Loredati-svg/BLDC-FOC-Motor-Driver/Hardware/FOC_Driver/FOC_Driver.kicad_pcb

## KiCad design Hardware/FOC_Driver/FOC_Driver.kicad_pcb (2026-10-24)

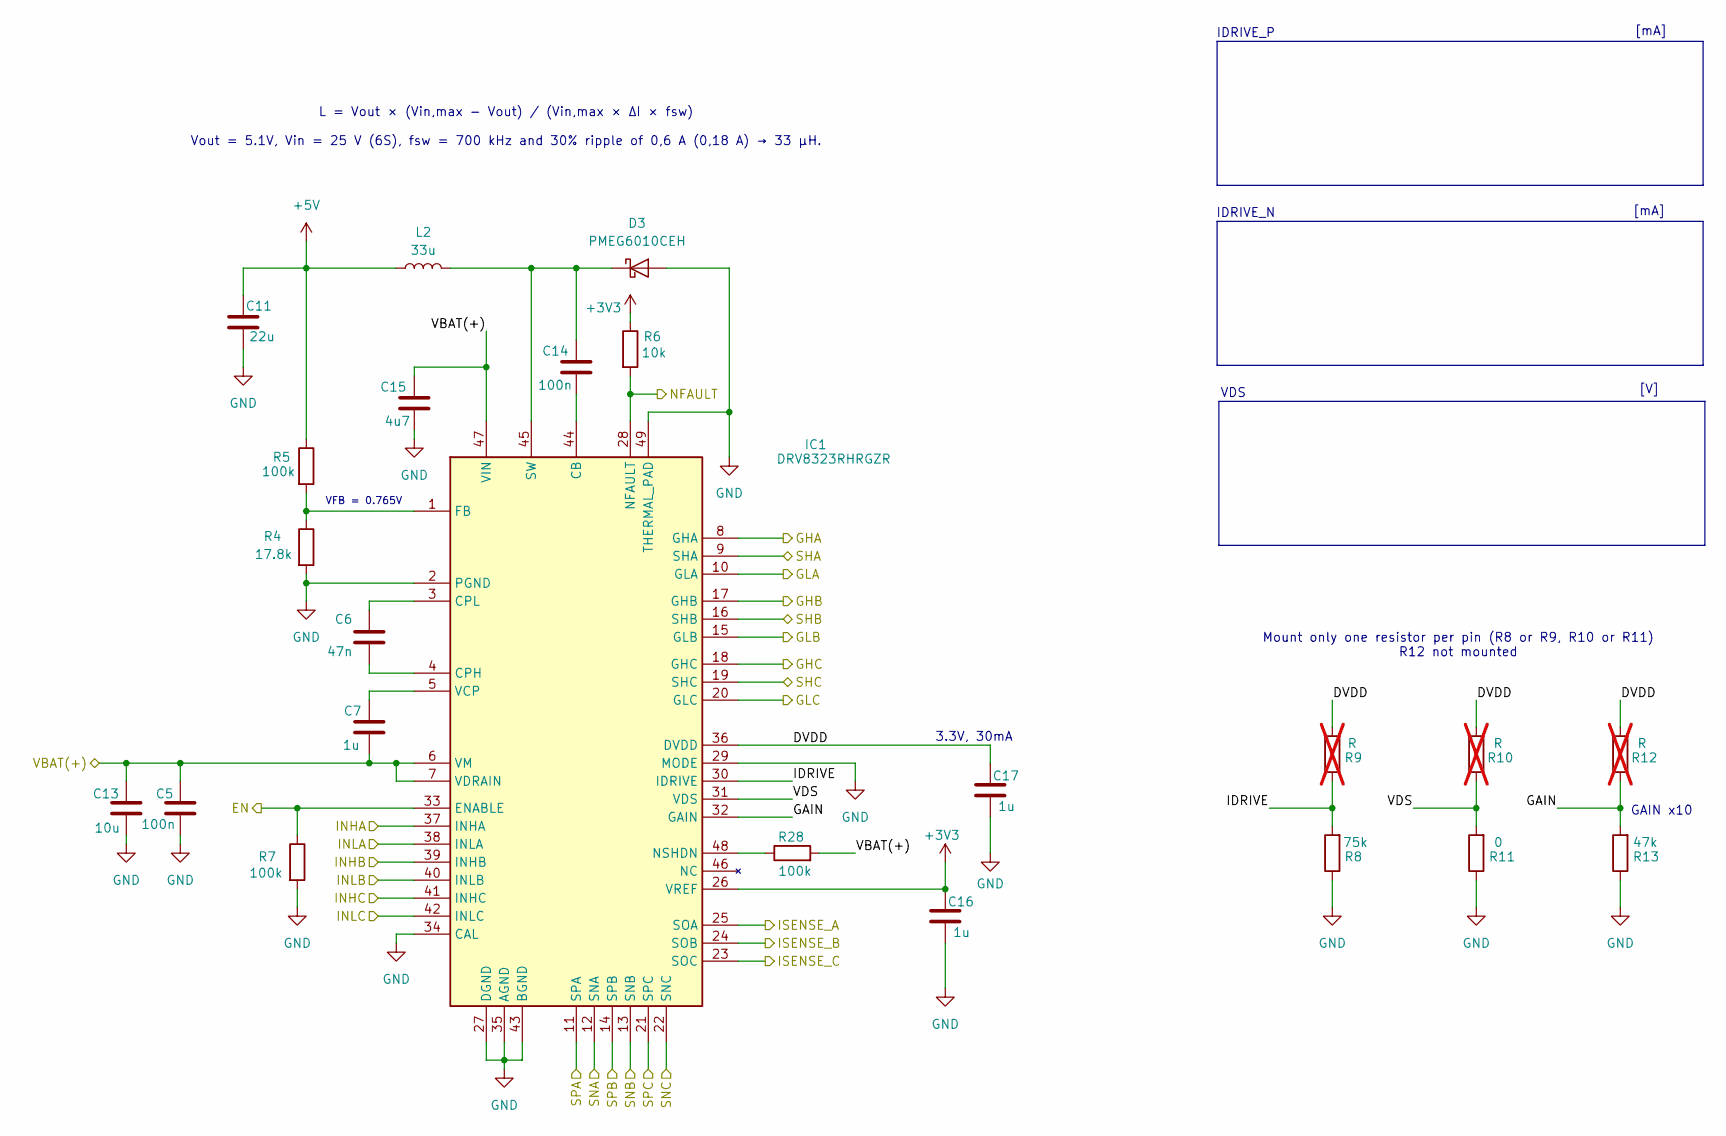
[picture p3: schematic Gate_Driver_sch.kicad_sch]

Parts:
C5: 100n; 0603
C6: 47n; 0603
C7: 1u; 0603
C11: 22u; 1206
C13: 10u; 1210
C14: 100n; 0402
C15: 4u7; 0805
C16, C17: 1u; 0402
D3: PMEG6010CEH; D_SOD-123F
IC1: DRV8323RHRGZR; QFN50P700X700X100-49N-D; Mouser Part Number 595-DRV8323RHRGZR
L2: 33u; L_Bourns_SRN6045TA
R4: 17.8k; 0402
R5, R7, R28: 100k; 0402
R6: 10k; 0402
R8: 75k; 0402
R9, R10, R12: R; 0402; not fitted
R11: 0; 0402
R13: 47k; 0402

Connections:
+3V3: C16.1, IC1.26 (VREF), R6.1; also elsewhere on the board
+5V: C11.1, L2.1, R5.1; also elsewhere on the board
/Gate_Driver/DVDD: C17.1, IC1.36 (DVDD), R9.2, R10.2, R12.2
/Gate_Driver/EN: IC1.33 (ENABLE), R7.1; also elsewhere on the board
/Gate_Driver/GAIN: IC1.32 (GAIN), R12.1, R13.2
/Gate_Driver/GHA: IC1.8 (GHA); also elsewhere on the board
/Gate_Driver/GHB: IC1.17 (GHB); also elsewhere on the board
/Gate_Driver/GHC: IC1.18 (GHC); also elsewhere on the board
/Gate_Driver/GLA: IC1.10 (GLA); also elsewhere on the board
/Gate_Driver/GLB: IC1.15 (GLB); also elsewhere on the board
/Gate_Driver/GLC: IC1.20 (GLC); also elsewhere on the board
/Gate_Driver/IDRIVE: IC1.30 (IDRIVE), R8.2, R9.1
/Gate_Driver/INHA: IC1.37 (INHA); also elsewhere on the board
/Gate_Driver/INHB: IC1.39 (INHB); also elsewhere on the board
/Gate_Driver/INHC: IC1.41 (INHC); also elsewhere on the board
/Gate_Driver/INLA: IC1.38 (INLA); also elsewhere on the board
/Gate_Driver/INLB: IC1.40 (INLB); also elsewhere on the board
/Gate_Driver/INLC: IC1.42 (INLC); also elsewhere on the board
/Gate_Driver/ISENSE_A: IC1.25 (SOA); also elsewhere on the board
/Gate_Driver/ISENSE_B: IC1.24 (SOB); also elsewhere on the board
/Gate_Driver/ISENSE_C: IC1.23 (SOC); also elsewhere on the board
/Gate_Driver/NFAULT: IC1.28 (NFAULT), R6.2; also elsewhere on the board
/Gate_Driver/SNA: IC1.12 (SNA); also elsewhere on the board
/Gate_Driver/SNB: IC1.13 (SNB); also elsewhere on the board
/Gate_Driver/SNC: IC1.22 (SNC); also elsewhere on the board
/Gate_Driver/SPA: IC1.11 (SPA); also elsewhere on the board
/Gate_Driver/SPB: IC1.14 (SPB); also elsewhere on the board
/Gate_Driver/SPC: IC1.21 (SPC); also elsewhere on the board
/Gate_Driver/VBAT(+): C5.1, C7.1, C13.1, C15.2, IC1.6 (VM), IC1.7 (VDRAIN), IC1.47 (VIN), R28.2; also elsewhere on the board
/Gate_Driver/VDS: IC1.31 (VDS), R10.1, R11.2
/SHA: IC1.9 (SHA); also elsewhere on the board
/SHB: IC1.16 (SHB); also elsewhere on the board
/SHC: IC1.19 (SHC); also elsewhere on the board
GND: C5.2, C11.2, C13.2, C15.1, C16.2, C17.2, D3.2 (A), IC1.2 (PGND), IC1.27 (DGND), IC1.29 (MODE), IC1.34 (CAL), IC1.35 (AGND), IC1.43 (BGND), IC1.49 (THERMAL_PAD), R4.2, R7.2, R8.1, R11.1, R13.1; also elsewhere on the board
unnamed: C14.2, D3.1 (K), IC1.45 (SW), L2.2
unnamed: C14.1, IC1.44 (CB)
unnamed: C6.1, IC1.4 (CPH)
unnamed: C6.2, IC1.3 (CPL)
unnamed: IC1.1 (FB), R4.1, R5.2
unnamed: IC1.48 (NSHDN), R28.1
unnamed: C7.2, IC1.5 (VCP)

Notes on the sheet:
[V]
3.3V, 30mA
VDS
[mA]
VFB = 0.765V
GAIN x10
IDRIVE_P
Mount only one resistor per pin (R8 or R9, R10 or R11) R12 not mounted
IDRIVE_N
L = Vout × (Vin,max − Vout) / (Vin,max × ΔI × fsw) Vout = 5.1V, Vin = 25 V (6S), fsw = 700 kHz and 30% ripple of 0,6 A (0,18 A) → 33 µH.

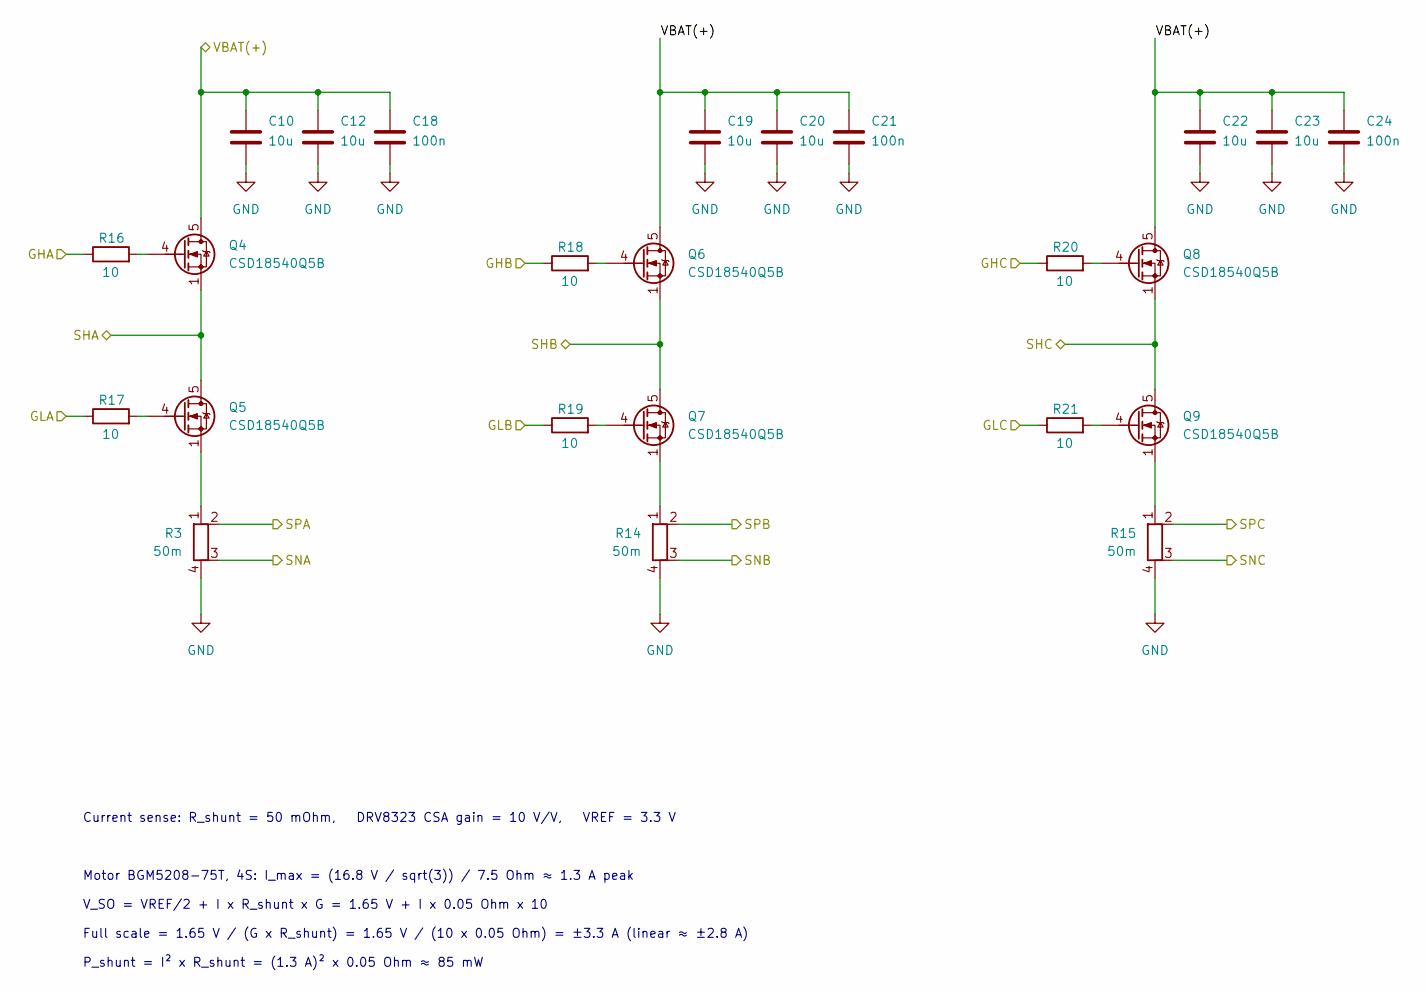
[picture p4: schematic Inverters_sch.kicad_sch]

Parts:
C10, C12, C19, C20, C22, C23: 10u; C_1206_3216Metric
C18, C21, C24: 100n; C_0603_1608Metric
Q4, Q5, Q6, Q7, Q8, Q9: CSD18540Q5B; TDSON-8-1
R3, R14, R15: 50m; R_Shunt_Vishay_WSK2512_6332Metric_T1.19mm
R16, R17, R18, R19, R20, R21: 10; R_0603_1608Metric

Connections:
/Gate_Driver/GHA: R16.1; also elsewhere on the board
/Gate_Driver/GHB: R18.1; also elsewhere on the board
/Gate_Driver/GHC: R20.1; also elsewhere on the board
/Gate_Driver/GLA: R17.1; also elsewhere on the board
/Gate_Driver/GLB: R19.1; also elsewhere on the board
/Gate_Driver/GLC: R21.1; also elsewhere on the board
/Gate_Driver/SNA: R3.3; also elsewhere on the board
/Gate_Driver/SNB: R14.3; also elsewhere on the board
/Gate_Driver/SNC: R15.3; also elsewhere on the board
/Gate_Driver/SPA: R3.2; also elsewhere on the board
/Gate_Driver/SPB: R14.2; also elsewhere on the board
/Gate_Driver/SPC: R15.2; also elsewhere on the board
/Gate_Driver/VBAT(+): C10.1, C12.1, C18.1, C19.1, C20.1, C21.1, C22.1, C23.1, C24.1, Q4.5 (D), Q6.5 (D), Q8.5 (D); also elsewhere on the board
/SHA: Q4.1 (S), Q4.2 (S), Q4.3 (S), Q5.5 (D); also elsewhere on the board
/SHB: Q6.1 (S), Q6.2 (S), Q6.3 (S), Q7.5 (D); also elsewhere on the board
/SHC: Q8.1 (S), Q8.2 (S), Q8.3 (S), Q9.5 (D); also elsewhere on the board
GND: C10.2, C12.2, C18.2, C19.2, C20.2, C21.2, C22.2, C23.2, C24.2, R3.4, R14.4, R15.4; also elsewhere on the board
unnamed: Q4.4 (G), R16.2
unnamed: Q5.4 (G), R17.2
unnamed: Q5.1 (S), Q5.2 (S), Q5.3 (S), R3.1
unnamed: Q6.4 (G), R18.2
unnamed: Q7.4 (G), R19.2
unnamed: Q7.1 (S), Q7.2 (S), Q7.3 (S), R14.1
unnamed: Q8.4 (G), R20.2
unnamed: Q9.4 (G), R21.2
unnamed: Q9.1 (S), Q9.2 (S), Q9.3 (S), R15.1

Notes on the sheet:
Current sense: R_shunt = 50 mOhm, DRV8323 CSA gain = 10 V/V, VREF = 3.3 V Motor BGM5208-75T, 4S: I_max = (16.8 V / sqrt(3)) / 7.5 Ohm ≈ 1.3 A peak V_SO = VREF/2 + I x R_shunt x G = 1.65 V + I x 0.05 Ohm x 10 Full scale = 1.65 V / (G x R_shunt) = 1.65 V / (10 x 0.05 Ohm) = ±3.3 A (linear ≈ ±2.8 A) P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

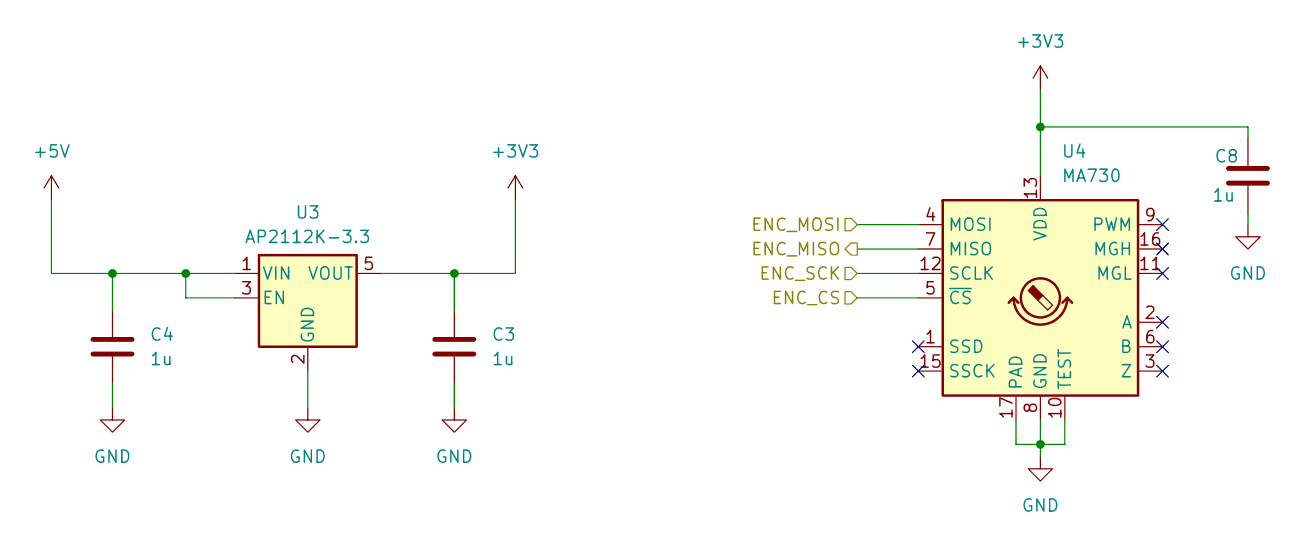
[picture p5: schematic LDO_sch.kicad_sch]

Parts:
C3, C4, C8: 1u; C_0402_1005Metric
U3: AP2112K-3.3; SOT-23-5
U4: MA730; QFN-16-1EP_3x3mm_P0.5mm_EP1.75x1.75mm

Connections:
+3V3: C3.1, C8.1, U3.5 (VOUT), U4.13 (VDD); also elsewhere on the board
+5V: C4.1, U3.1 (VIN), U3.3 (EN); also elsewhere on the board
/LDO + Encoder/ENC_CS: U4.5 (~CS); also elsewhere on the board
/LDO + Encoder/ENC_MISO: U4.7 (MISO); also elsewhere on the board
/LDO + Encoder/ENC_MOSI: U4.4 (MOSI); also elsewhere on the board
/LDO + Encoder/ENC_SCK: U4.12 (SCLK); also elsewhere on the board
GND: C3.2, C4.2, C8.2, U3.2 (GND), U4.8 (GND), U4.10 (TEST), U4.17 (PAD); also elsewhere on the board

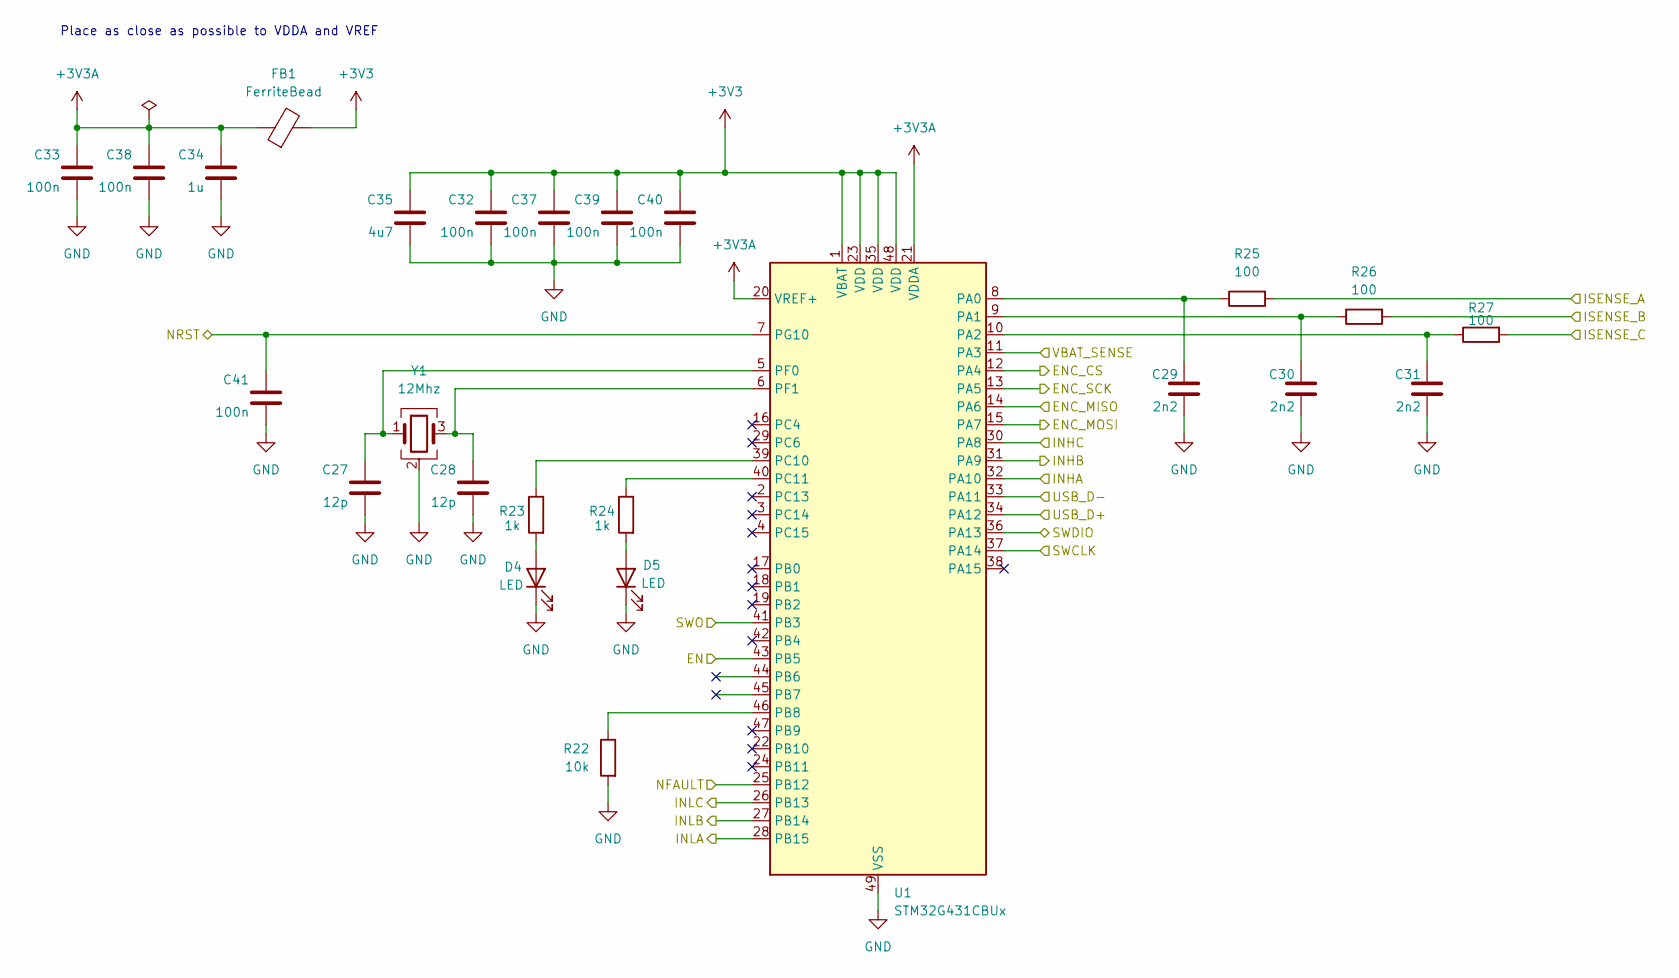
[picture p6: schematic MCU_sch.kicad_sch]

Parts:
C27, C28: 12p; 0402
C29, C30, C31: 2n2; 0402
C32, C33, C37, C38, C39, C40, C41: 100n; 0402
C34: 1u; 0603
C35: 4u7; 0805
D4, D5: LED; 0603_pol
FB1: FerriteBead; 0603
R22: 10k; 0402
R23, R24: 1k; 0402
R25, R26, R27: 100; 0402
U1: STM32G431CBUx; QFN-48-1EP_7x7mm_P0.5mm_EP5.6x5.6mm
Y1: 12Mhz; Crystal_SMD_ECX-32_Series_4Pin_3.2x2.5mm

Connections:
+3V3: C32.2, C35.2, C37.2, C39.2, C40.2, FB1.2, U1.1 (VBAT), U1.23 (VDD), U1.35 (VDD), U1.48 (VDD); also elsewhere on the board
+3V3A: C33.2, C34.2, C38.2, FB1.1, U1.20 (VREF+), U1.21 (VDDA)
/Connectors/NRST: C41.2, U1.7 (PG10); also elsewhere on the board
/Connectors/SWCLK: U1.37 (PA14); also elsewhere on the board
/Connectors/SWDIO: U1.36 (PA13); also elsewhere on the board
/Connectors/SWO: U1.41 (PB3); also elsewhere on the board
/Connectors/USB_D+: U1.34 (PA12); also elsewhere on the board
/Connectors/USB_D-: U1.33 (PA11); also elsewhere on the board
/Connectors/VBAT_SENSE: U1.11 (PA3); also elsewhere on the board
/Gate_Driver/EN: U1.43 (PB5); also elsewhere on the board
/Gate_Driver/INHA: U1.32 (PA10); also elsewhere on the board
/Gate_Driver/INHB: U1.31 (PA9); also elsewhere on the board
/Gate_Driver/INHC: U1.30 (PA8); also elsewhere on the board
/Gate_Driver/INLA: U1.28 (PB15); also elsewhere on the board
/Gate_Driver/INLB: U1.27 (PB14); also elsewhere on the board
/Gate_Driver/INLC: U1.26 (PB13); also elsewhere on the board
/Gate_Driver/ISENSE_A: R25.2; also elsewhere on the board
/Gate_Driver/ISENSE_B: R26.2; also elsewhere on the board
/Gate_Driver/ISENSE_C: R27.2; also elsewhere on the board
/Gate_Driver/NFAULT: U1.25 (PB12); also elsewhere on the board
/LDO + Encoder/ENC_CS: U1.12 (PA4); also elsewhere on the board
/LDO + Encoder/ENC_MISO: U1.14 (PA6); also elsewhere on the board
/LDO + Encoder/ENC_MOSI: U1.15 (PA7); also elsewhere on the board
/LDO + Encoder/ENC_SCK: U1.13 (PA5); also elsewhere on the board
GND: C27.1, C28.1, C29.1, C30.1, C31.1, C32.1, C33.1, C34.1, C35.1, C37.1, C38.1, C39.1, C40.1, C41.1, D4.1 (K), D5.1 (K), R22.2, U1.49 (VSS), Y1.2 (G), Y1.4 (G); also elsewhere on the board
unnamed: D4.2 (A), R23.2
unnamed: D5.2 (A), R24.2
unnamed: C29.2, R25.1, U1.8 (PA0)
unnamed: C30.2, R26.1, U1.9 (PA1)
unnamed: C31.2, R27.1, U1.10 (PA2)
unnamed: R22.1, U1.46 (PB8)
unnamed: R23.1, U1.39 (PC10)
unnamed: R24.1, U1.40 (PC11)
unnamed: C27.2, U1.5 (PF0), Y1.1
unnamed: C28.2, U1.6 (PF1), Y1.3

Notes on the sheet:
Place as close as possible to VDDA and VREF

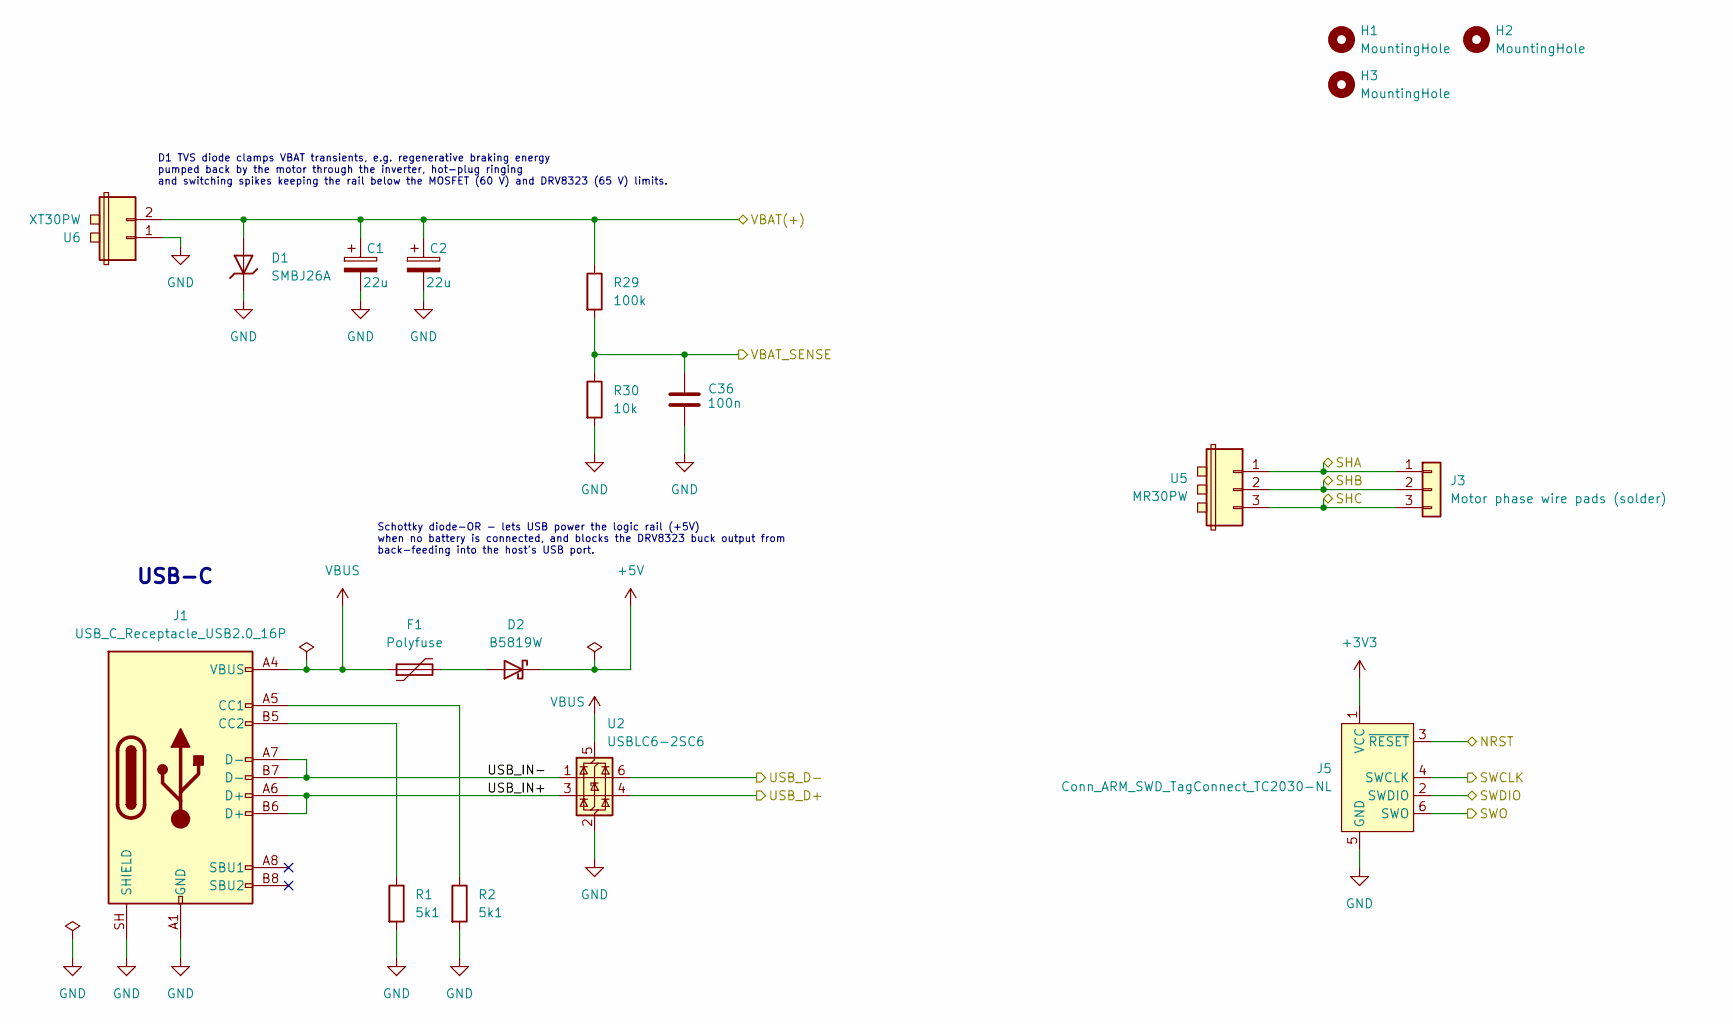
[picture p7: schematic Connectors_sch.kicad_sch]

Parts:
C1, C2: 22u; CP_Elec_6.3x5.4
C36: 100n; 0402
D1: SMBJ26A; D_SMB; Part SMBJ26A; LCSC C19077580
D2: B5819W; D_SOD-123; Forward Voltage (Vf@If) 900mV@3A; Reverse Voltage (Vr) 40V; Part B5819W; LCSC C64885
F1: Polyfuse; Fuse_1206_3216Metric
H1, H2, H3: MountingHole; MountingHole_2.7mm_M2.5_DIN965_Pad_TopOnly
J1: USB_C_Receptacle_USB2.0_16P; USB_C_Receptacle_GCT_USB4105-xx-A_16P_TopMnt_Horizontal
J3: Motor phase wire pads (solder); SolderWire-0.5sqmm_1x03_P4.6mm_D0.9mm_OD2.1mm
J5: Conn_ARM_SWD_TagConnect_TC2030-NL; Tag-Connect_TC2030-IDC-NL_2x03_P1.27mm_Vertical
R1, R2: 5k1; R_0402_1005Metric
R29: 100k; 0603
R30: 10k; 0603
U2: USBLC6-2SC6; SOT-23-6
U5: MR30PW; AMASS_MR30PW-M_1x03_P3.50mm_Horizontal
U6: XT30PW; AMASS_XT30PW-M_1x02_P2.50mm_Horizontal

Connections:
+3V3: J5.1 (VCC); also elsewhere on the board
+5V: D2.1; also elsewhere on the board
/Connectors/NRST: J5.3 (~RESET); also elsewhere on the board
/Connectors/SWCLK: J5.4 (SWCLK); also elsewhere on the board
/Connectors/SWDIO: J5.2 (SWDIO); also elsewhere on the board
/Connectors/SWO: J5.6 (SWO); also elsewhere on the board
/Connectors/USB_D+: U2.4 (I/O2); also elsewhere on the board
/Connectors/USB_D-: U2.6 (I/O1); also elsewhere on the board
/Connectors/USB_IN+: J1.A6 (D+), J1.B6 (D+), U2.3 (I/O2)
/Connectors/USB_IN-: J1.A7 (D-), J1.B7 (D-), U2.1 (I/O1)
/Connectors/VBAT_SENSE: C36.2, R29.2, R30.1; also elsewhere on the board
/Gate_Driver/VBAT(+): C1.1, C2.1, D1.2, R29.1, U6.2; also elsewhere on the board
/SHA: J3.1, U5.1; also elsewhere on the board
/SHB: J3.2, U5.2; also elsewhere on the board
/SHC: J3.3, U5.3; also elsewhere on the board
GND: C1.2, C2.2, C36.1, D1.1, J1.A1 (GND), J1.A12 (GND), J1.B1 (GND), J1.B12 (GND), J1.SH (SHIELD), J5.5 (GND), R1.2, R2.2, R30.2, U2.2 (GND), U6.1; also elsewhere on the board
unnamed: D2.2, F1.2
unnamed: J1.A5 (CC1), R2.1
unnamed: J1.B5 (CC2), R1.1
VBUS: F1.1, J1.A4 (VBUS), J1.A9 (VBUS), J1.B4 (VBUS), J1.B9 (VBUS), U2.5 (VBUS)

Notes on the sheet:
Schottky diode-OR - lets USB power the logic rail (+5V) when no battery is connected, and blocks the DRV8323 buck output from back-feeding into the host's USB port.
D1 TVS diode clamps VBAT transients, e.g. regenerative braking energy pumped back by the motor through the inverter, hot-plug ringing and switching spikes keeping the rail below the MOSFET (60 V) and DRV8323 (65 V) limits.
USB-C

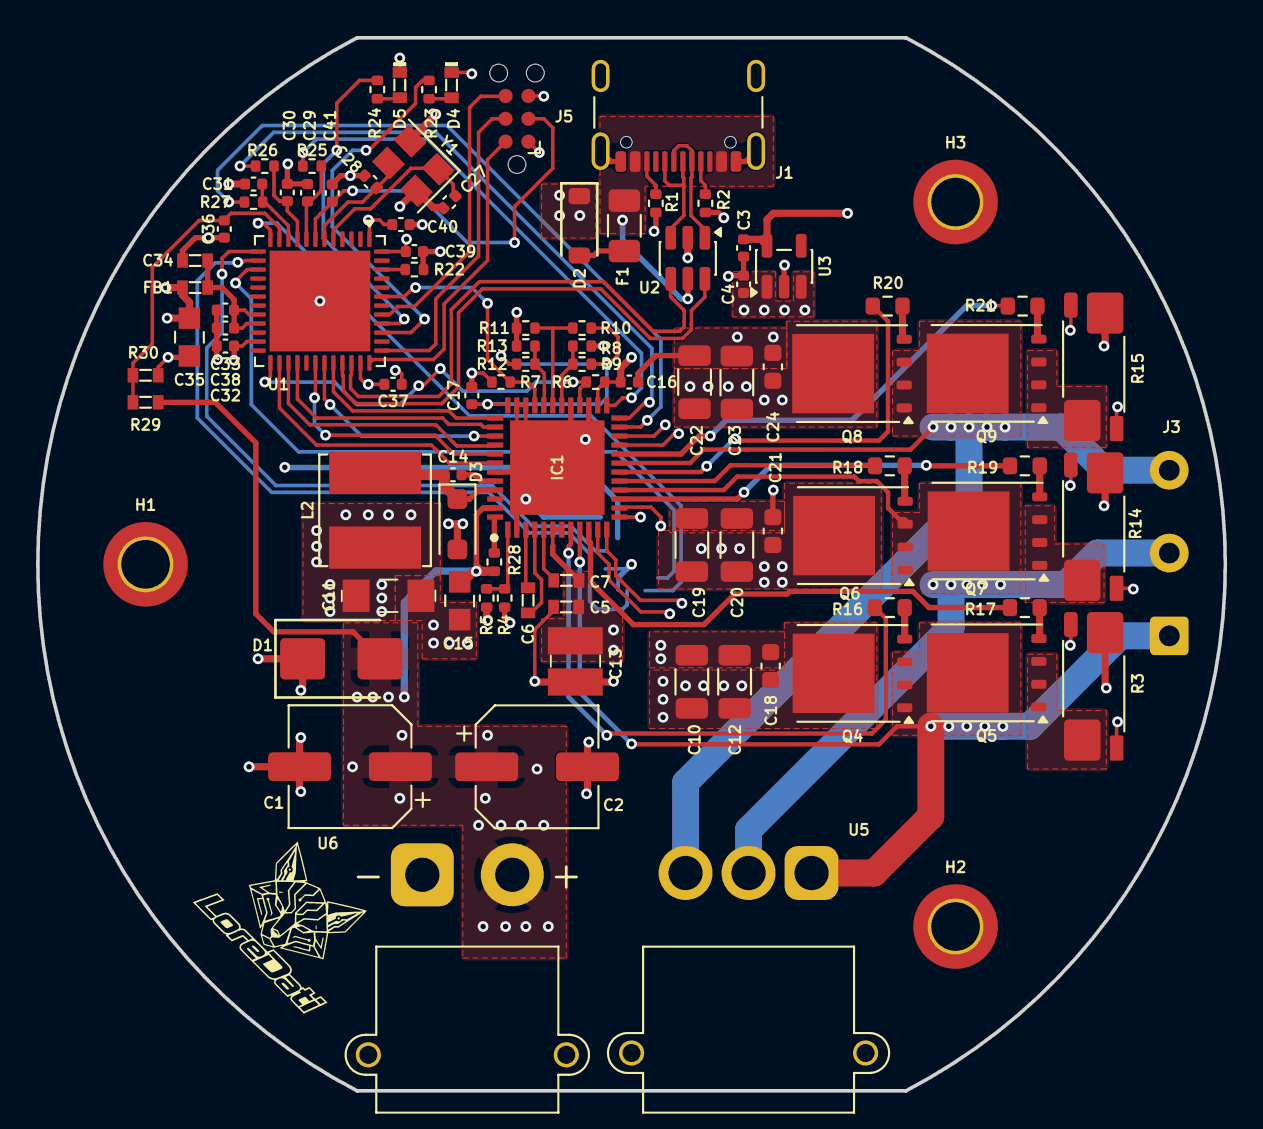
[picture p8: board FOC_Driver.kicad_pcb from above]

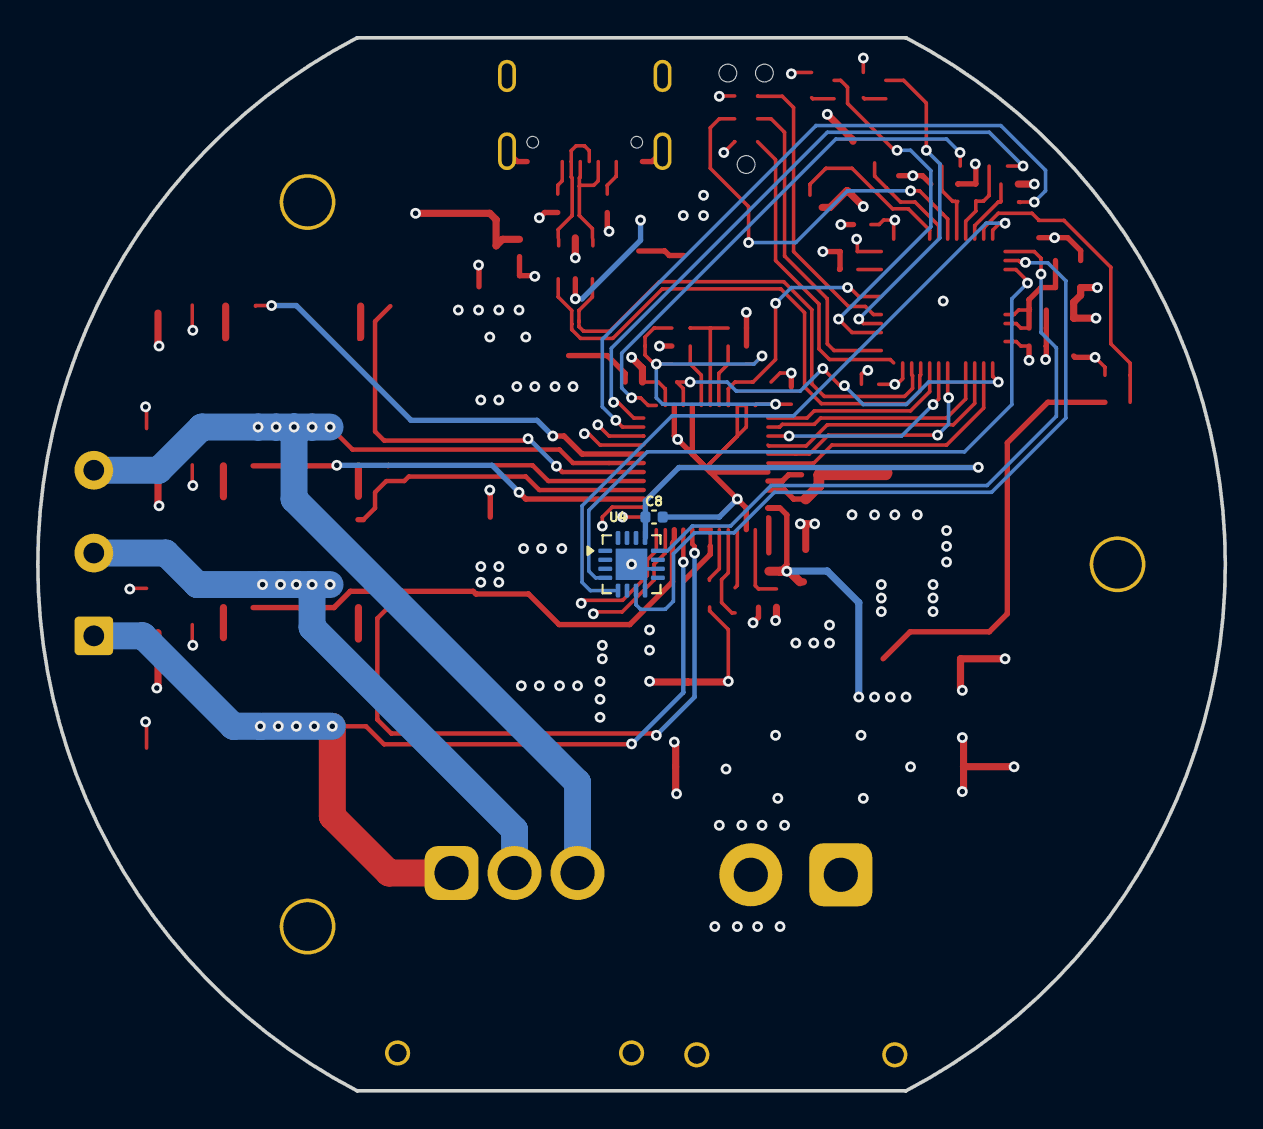
[picture p9: board FOC_Driver.kicad_pcb from below]

Board: 4 copper layers, 66.0 x 58.5 mm, 96 parts (2 on the bottom side), 78 nets.
