Loredati-svg/BLDC-FOC-Motor-Driver/Firmware/Firmware.ioc

Mcu.UserName=STM32G431CBUx
PA0.GPIO_Label=ISENSE_A
PA0.Signal=ADC1_IN1
PA1.GPIO_Label=ISENSE_B
PA1.Signal=ADC1_IN2
PA10.GPIO_Label=INHC
PA10.Signal=S_TIM1_CH3
PA11.Signal=USB_DM
PA12.Signal=USB_DP
PA13.Signal=SYS_JTMS-SWDIO
PA14.Signal=SYS_JTCK-SWCLK
PA2.GPIO_Label=ISENSE_C
PA2.Signal=ADC1_IN3
PA3.Signal=ADC1_IN4
PA4.GPIO_Label=ENC_CS
PA4.Signal=GPIO_Output
PA5.Signal=SPI1_SCK
PA6.Signal=SPI1_MISO
PA7.Signal=SPI1_MOSI
PA8.GPIO_Label=INHA
PA8.Signal=S_TIM1_CH1
PA9.GPIO_Label=INHB
PA9.Signal=S_TIM1_CH2
PB12.GPIO_Label=NFAULT
PB12.Signal=GPIO_Input
PB13.GPIO_Label=INLA
PB13.Signal=TIM1_CH1N
PB14.GPIO_Label=INLB
PB14.Signal=TIM1_CH2N
PB15.GPIO_Label=INLC
PB15.Signal=TIM1_CH3N
PB3.Signal=SYS_JTDO-SWO
PB5.GPIO_Label=EN
PB5.Signal=GPIO_Output
PB6.Signal=USART1_TX
PB7.Signal=USART1_RX
PC10.GPIO_Label=LED_STATUS
PC10.Signal=GPIO_Output
PC11.GPIO_Label=LED_FAULT
PC11.Signal=GPIO_Output
PF0-OSC_IN.Signal=RCC_OSC_IN
PF1-OSC_OUT.Signal=RCC_OSC_OUT
