Loredati-svg/BLDC-FOC-Motor-Driver/(commit log)

2026-10-20 Initial hardware: KiCad project, libraries, architecture PDF
    [Connectors_sch.kicad_sch, FOC_Driver.kicad_pcb, FOC_Driver.kicad_sch, Gate_Driver_sch.kicad_sch, Inverters_sch.kicad_sch, LDO_sch.kicad_sch, MCU_sch.kicad_sch]
2026-10-20 Use shared Kicad_Libs instead of project-specific libraries
    - Project parts moved to Kicad_Libs (symbol, footprint, 3D, datasheet)
    - Lib tables point to ${KIPRJMOD}/../KiCad_Libs (link via bring_libs.bat)
    - Schematic/PCB references (lib ids, footprints, 3D paths, datasheets)
    updated to the Kicad_Libs libraries; no design changes
    - Removed the old project-specific library folder
    [Gate_Driver_sch.kicad_sch]
2026-10-21 schematic updates
    [Connectors_sch.kicad_sch, FOC_Driver.kicad_sch, Gate_Driver_sch.kicad_sch, Inverters_sch.kicad_sch, LDO_sch.kicad_sch]
2026-10-21 Schematic update and Firmware folder
    [Gate_Driver_sch.kicad_sch, LDO_sch.kicad_sch, MCU_sch.kicad_sch]
2026-10-22 Update README with KiCad library instructions
    Added instructions for using shared KiCad libraries and updated project structure details.
2026-10-22 schematic completed
    [Connectors_sch.kicad_sch, FOC_Driver.kicad_sch, Gate_Driver_sch.kicad_sch, Inverters_sch.kicad_sch, LDO_sch.kicad_sch, MCU_sch.kicad_sch]
2026-10-22 Schematic update, XT30/MR30 connectors and PCB layout in progress
    - Connectors: AMASS XT30PW and MR30PW from Kicad_Libs (eConnector)
    - Schematic updates on main, MCU and gate driver sheets
    - PCB: footprints placed, routing in progress
    [Connectors_sch.kicad_sch, FOC_Driver.kicad_pcb, FOC_Driver.kicad_sch, Gate_Driver_sch.kicad_sch, MCU_sch.kicad_sch]
2026-10-22 Add DNP spare pads for R9, R10, R12 (0603)
    - Gate driver: R9, R10, R12 get eResistor:0603 footprint, kept DNP
    - PCB: spare 0603 pads placed, excluded from BOM and assembly
    [FOC_Driver.kicad_pcb, Gate_Driver_sch.kicad_sch]
2026-10-24 Finished positioning and started layout v2
    [Connectors_sch.kicad_sch, FOC_Driver.kicad_pcb, Gate_Driver_sch.kicad_sch, Inverters_sch.kicad_sch]
2026-10-24 Layout completed
    [FOC_Driver.kicad_pcb, FOC_Driver.kicad_sch, MCU_sch.kicad_sch]
2026-10-24 added images
    [FOC_Driver.kicad_pcb]
2026-10-24 Add images of the test board to README
    Added images to README for visual reference.
